silabs-MikeY/Peltier-Cell-Driver/ADC_Board.step

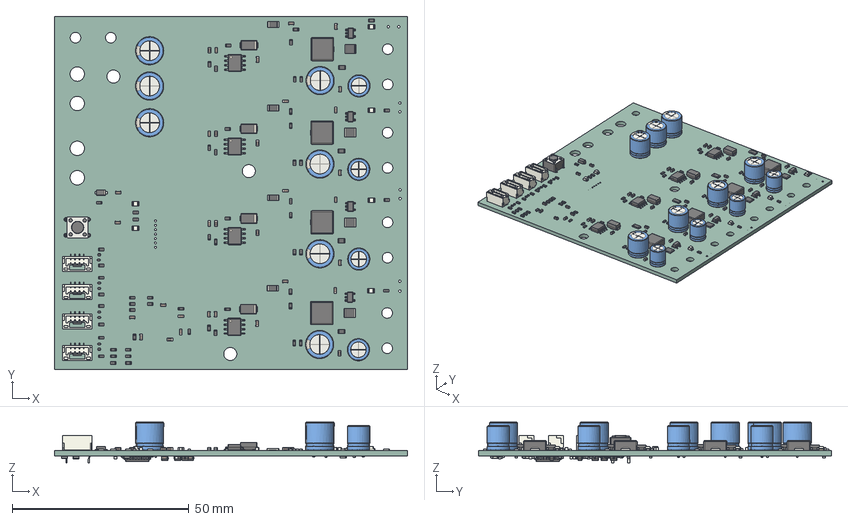
[picture p1: CAD file, 2026-09-24]
ADC_Board.step
100.0 x 100.0 x 11.5 mm
R_0603_1608Metric x 74
C_0603_1608Metric x 44
LED_0805_2012Metric x 6
SOIC-8_3.9x4.9mm_P1.27mm x 4
R_1210_3225Metric x 4
SOT-23-5 x 4
Fuse_1206_3216Metric x 8
C_Radial_D63mm_H70mm_P250mm x 4
D_SOD_923 x 14
D_SMA x 4
CP_Radial_D80mm_P350mm x 7
L_Changjiang_FXL0630 x 4
R_0805_2012Metric x 4
JST_BM04B_GHS_TBT x 4
SW_PUSH_6mm
D_SOD_123F
SOT-323_SC-70 x 7
LQFP-32_7x7mm_P0.8mm
ADCD332_PCB
