silabs-MikeY/Peltier-Cell-Driver/ADC_Board.pdf

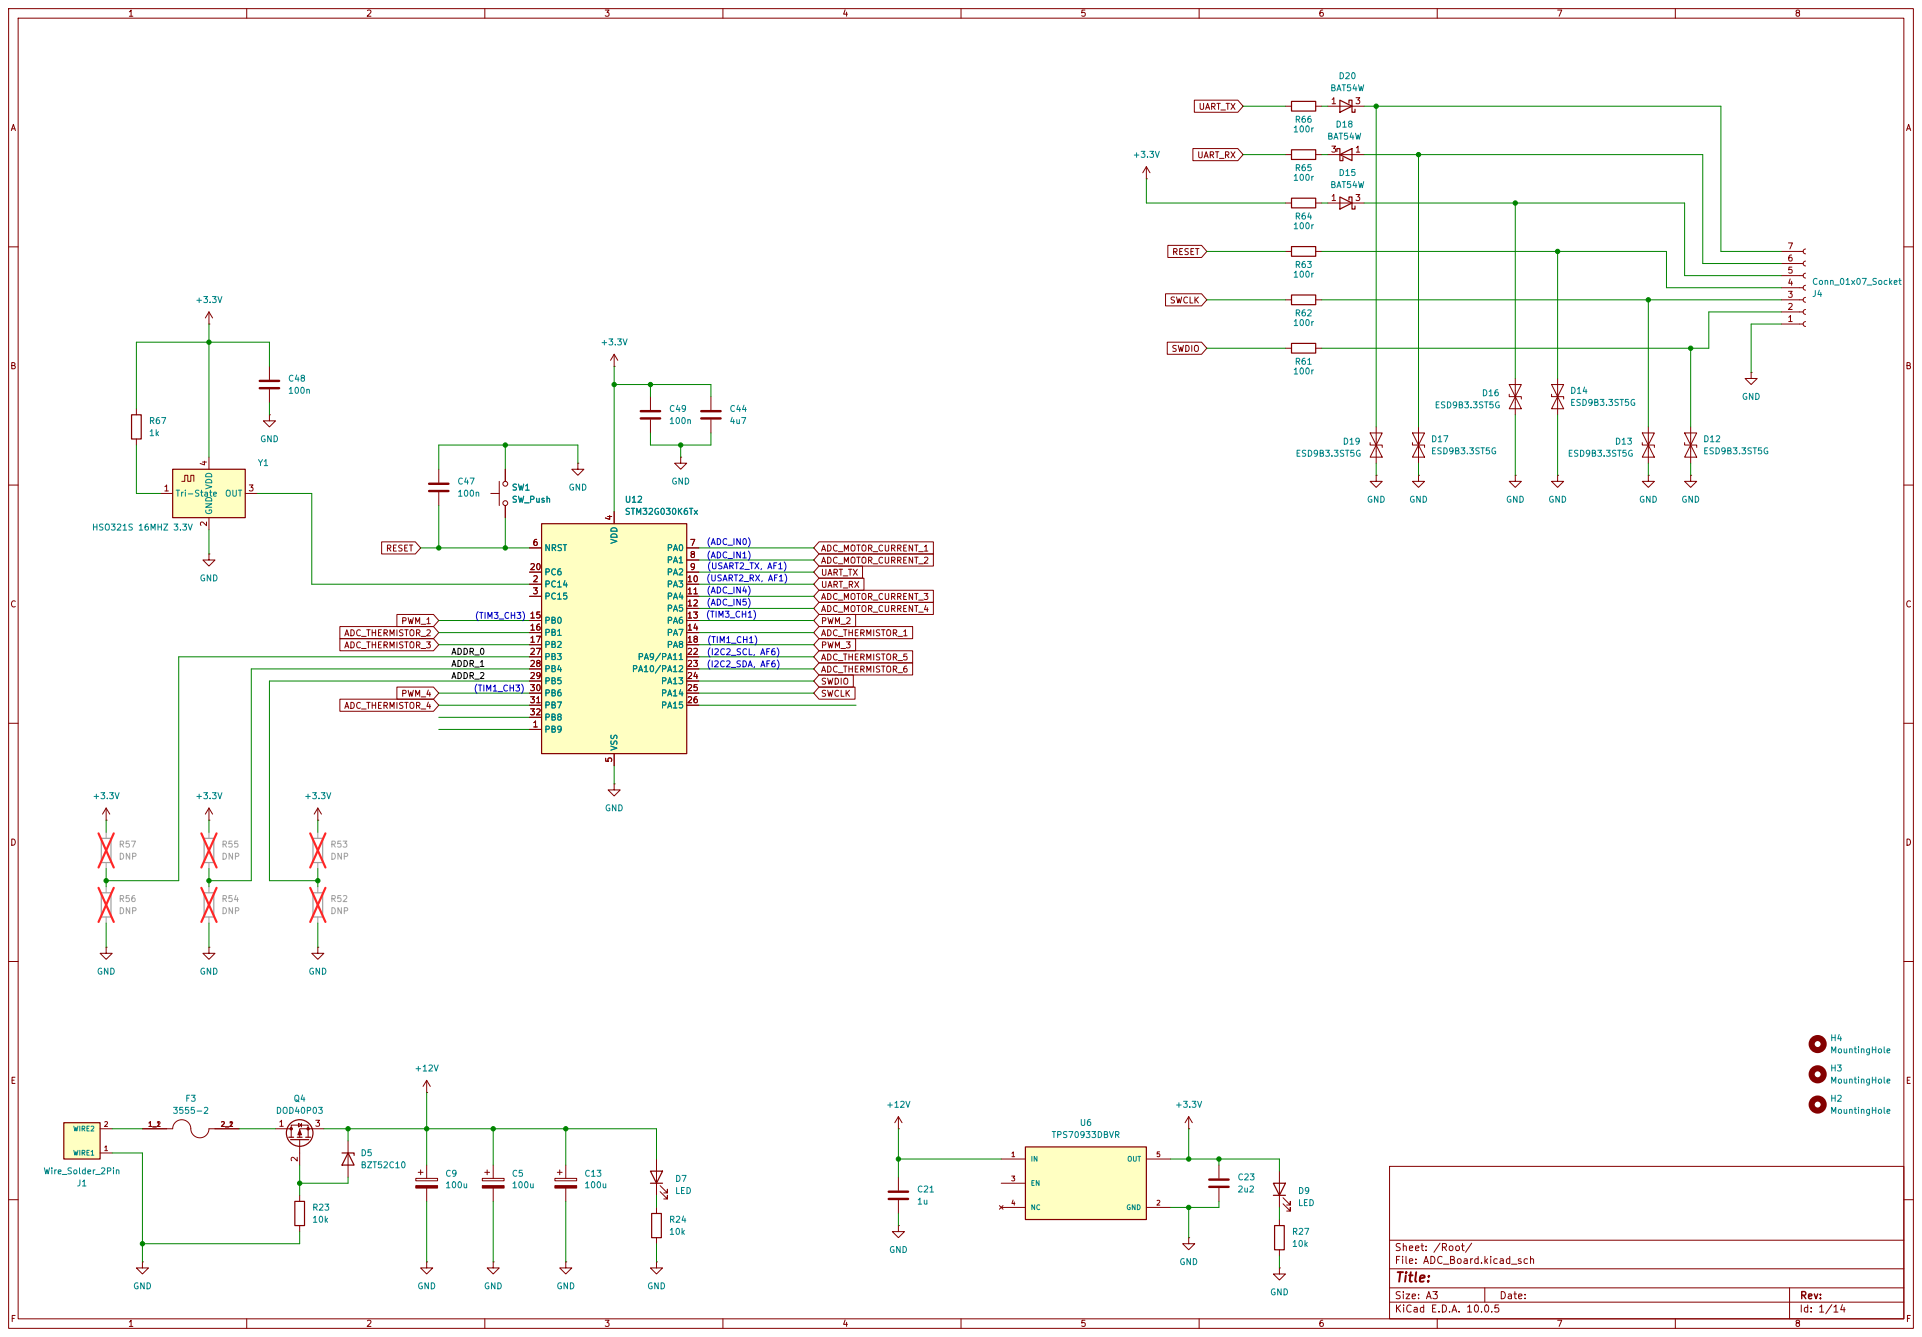
[picture p2: page 1]

Size: A3 | Rev: | F Date:
KiCad E.D.A. 10.0.5 | Id: 1/14

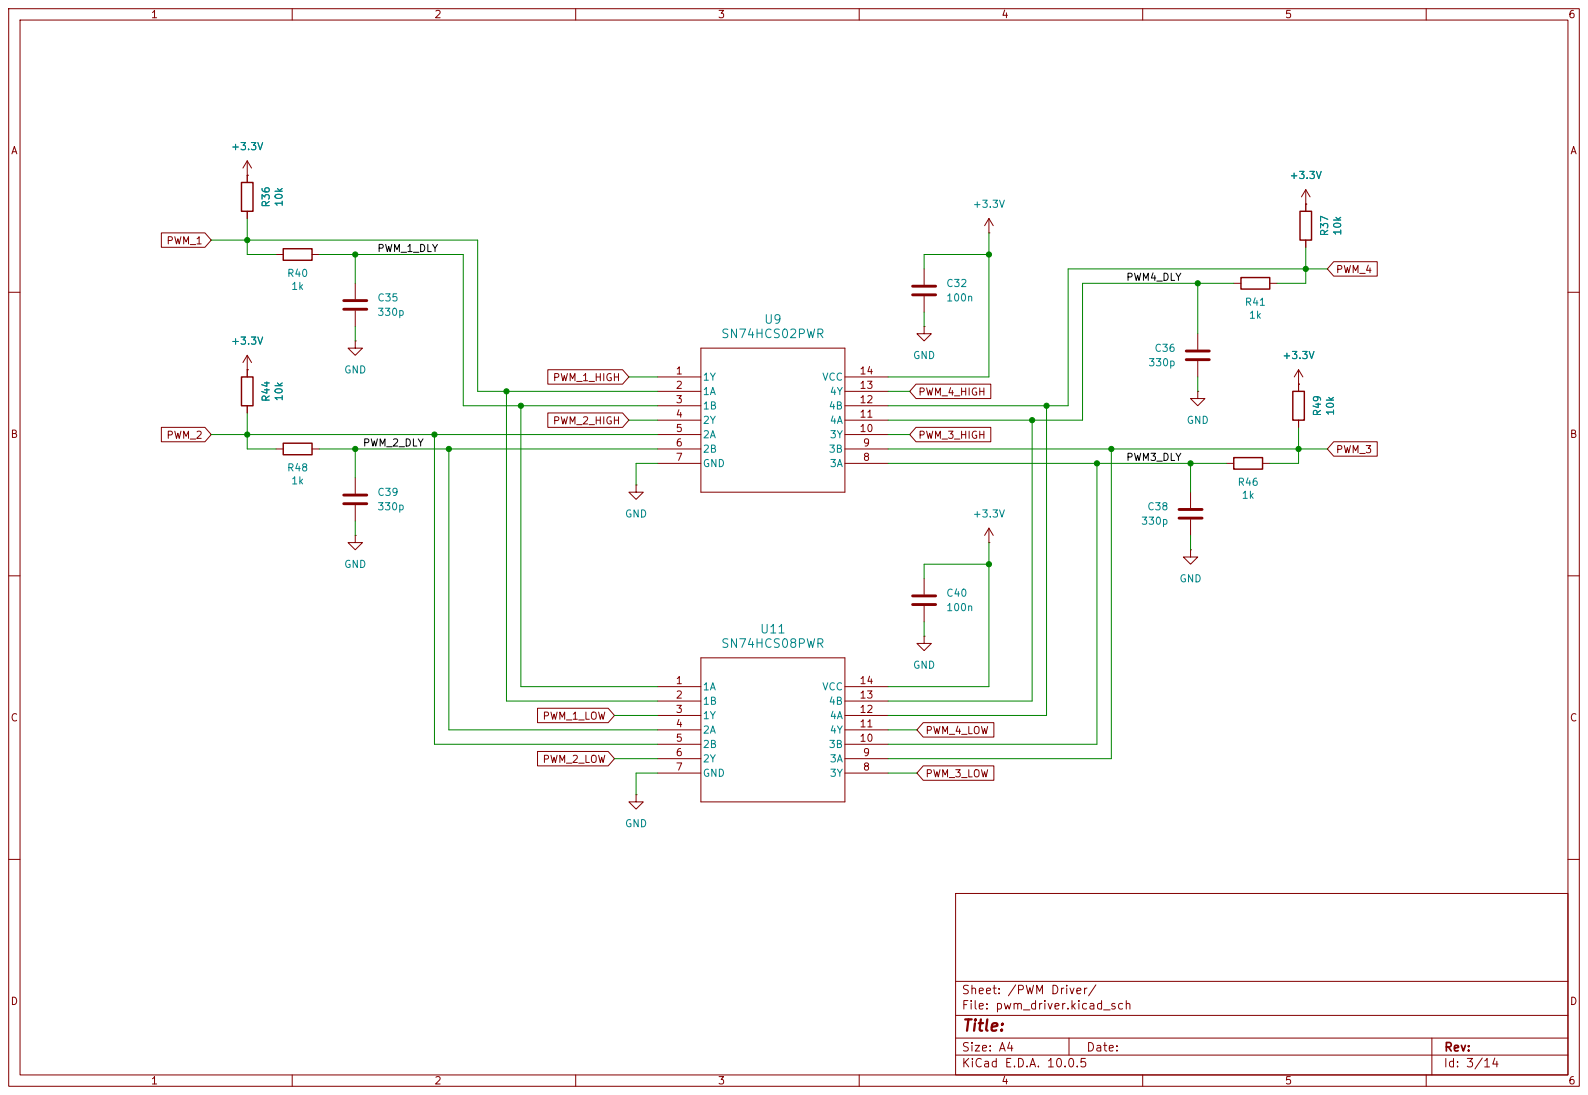
[picture p3: page 2]

1B 3
2Y 4 2A 5 2B 6 GND 7

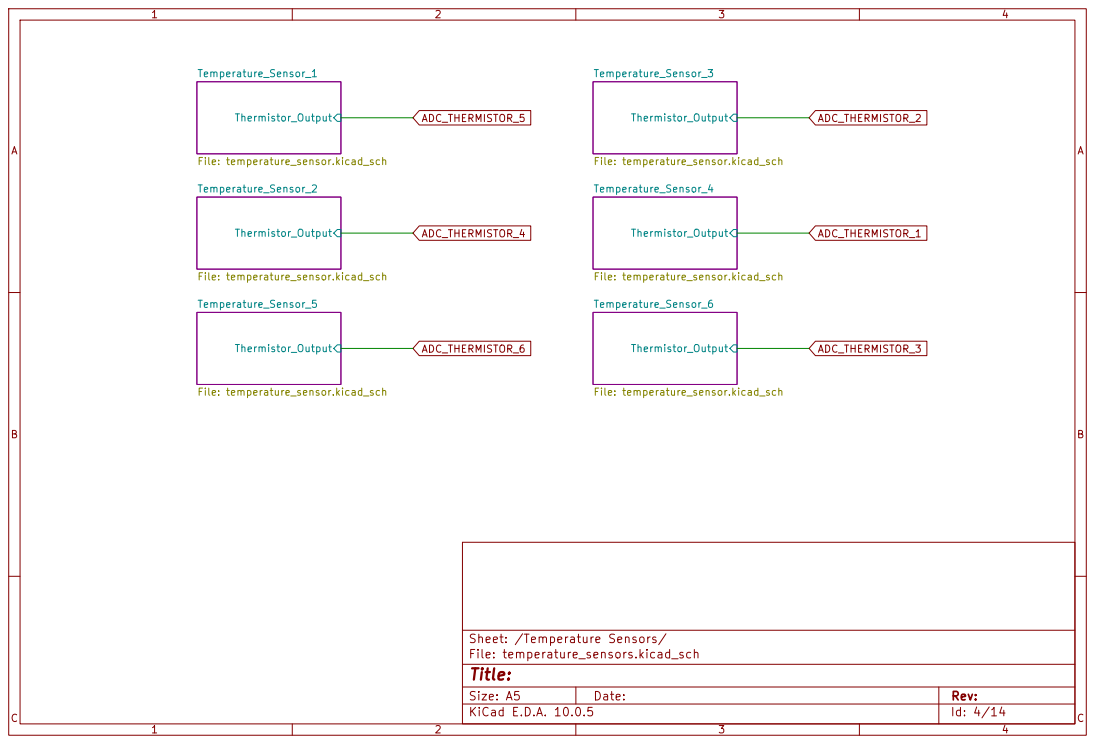
[picture p4: page 3]

Size: A5 | Rev: | C Date:
KiCad E.D.A. 10.0.5 | Id: 4/14

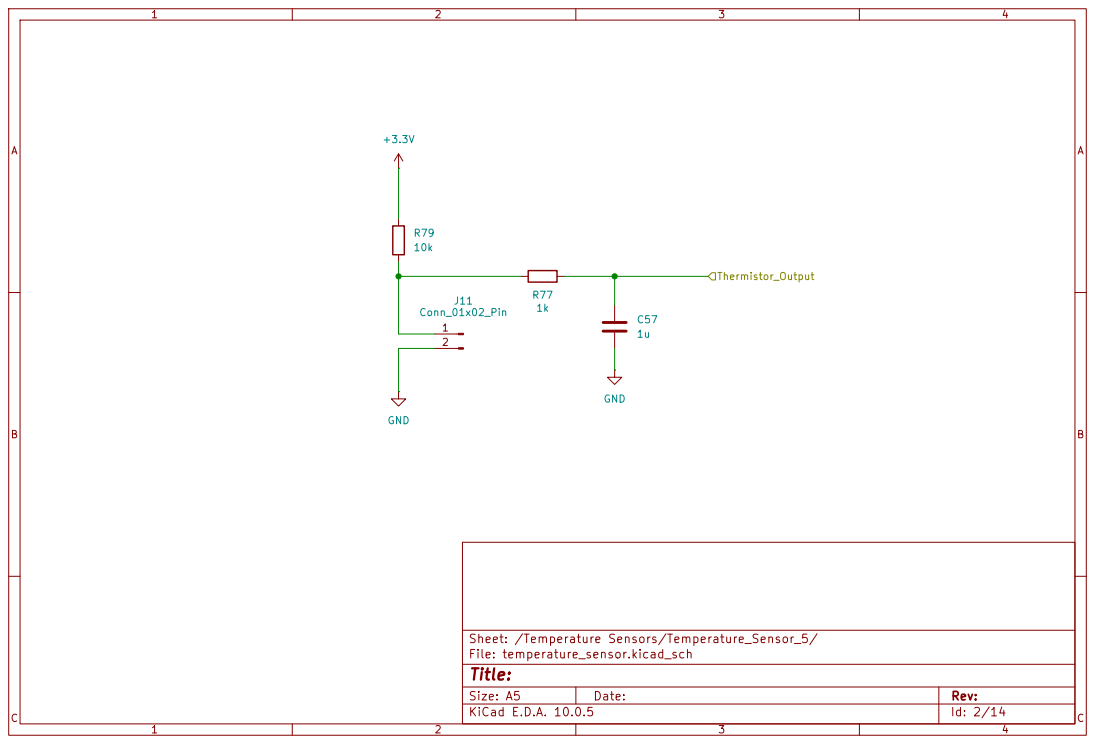
[picture p5: page 4]

Size: A5 | Rev: | C Date:
KiCad E.D.A. 10.0.5 | Id: 2/14

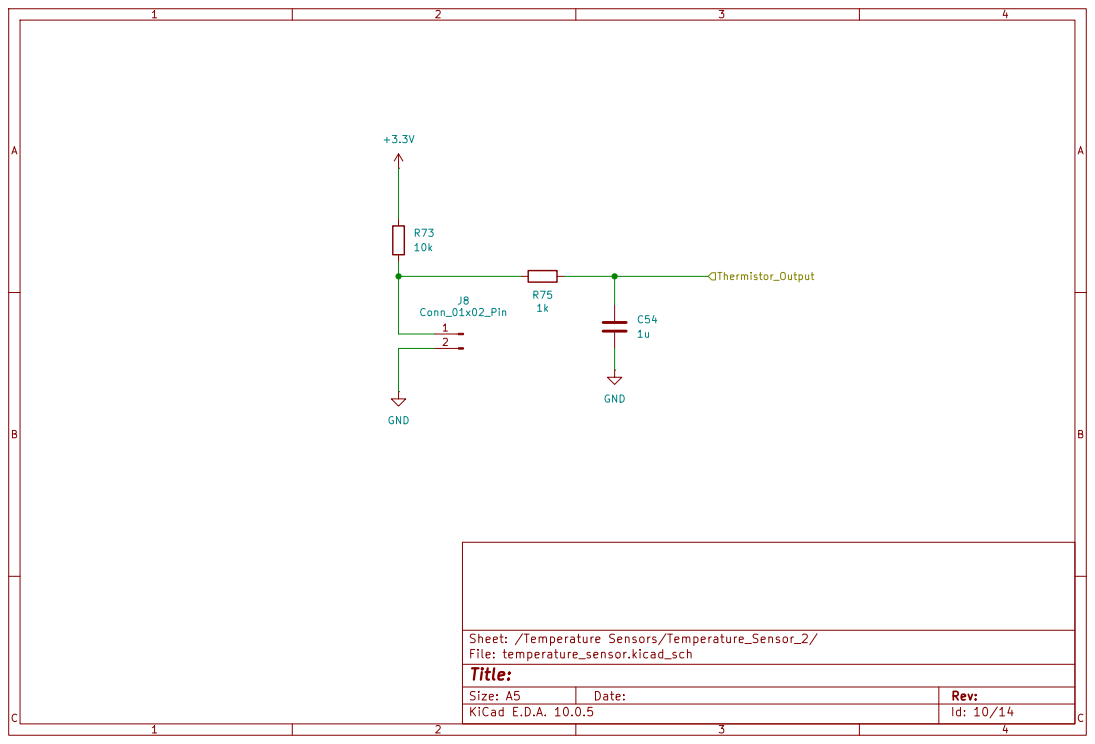
[picture p6: page 5]

Size: A5 | Rev: | C Date:
KiCad E.D.A. 10.0.5 | Id: 10/14

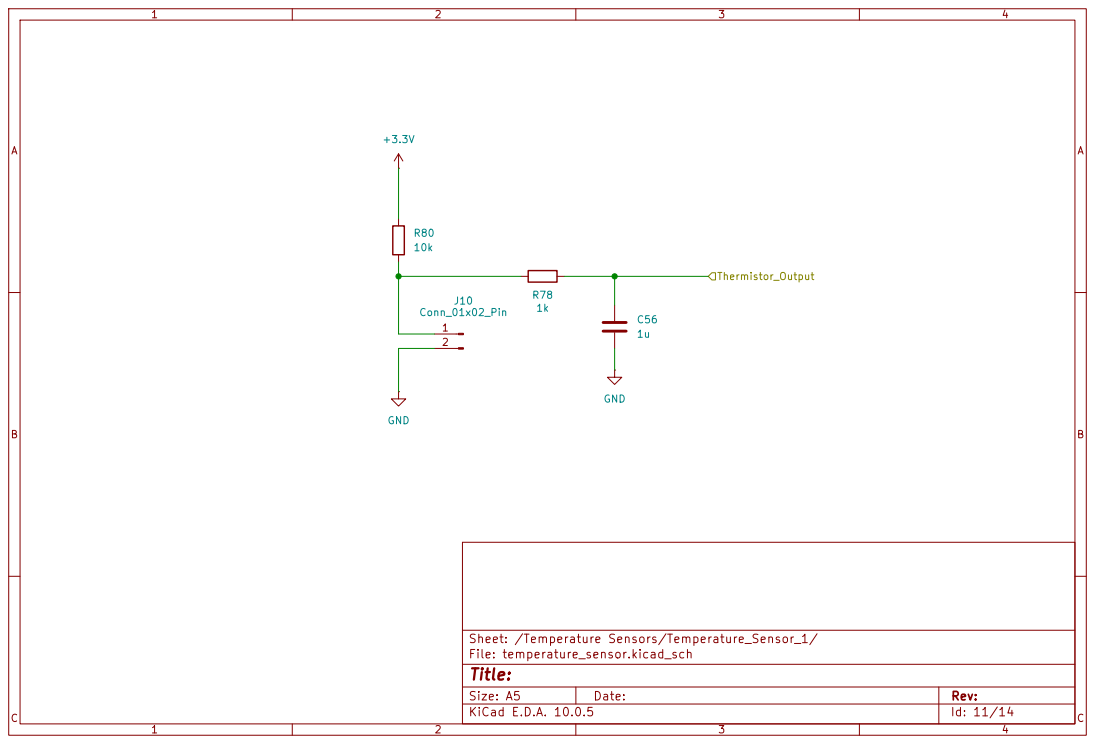
[picture p7: page 6]

Size: A5 | Rev: | C Date:
KiCad E.D.A. 10.0.5 | Id: 11/14

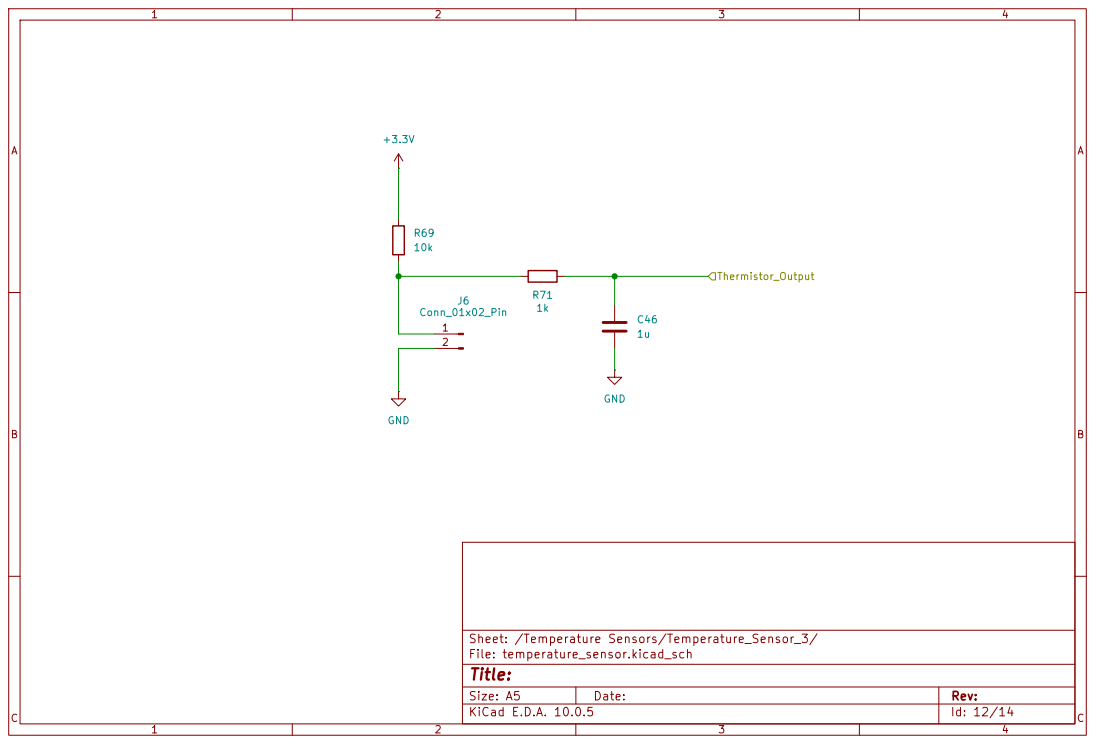
[picture p8: page 7]

Size: A5 | Rev: | C Date:
KiCad E.D.A. 10.0.5 | Id: 12/14

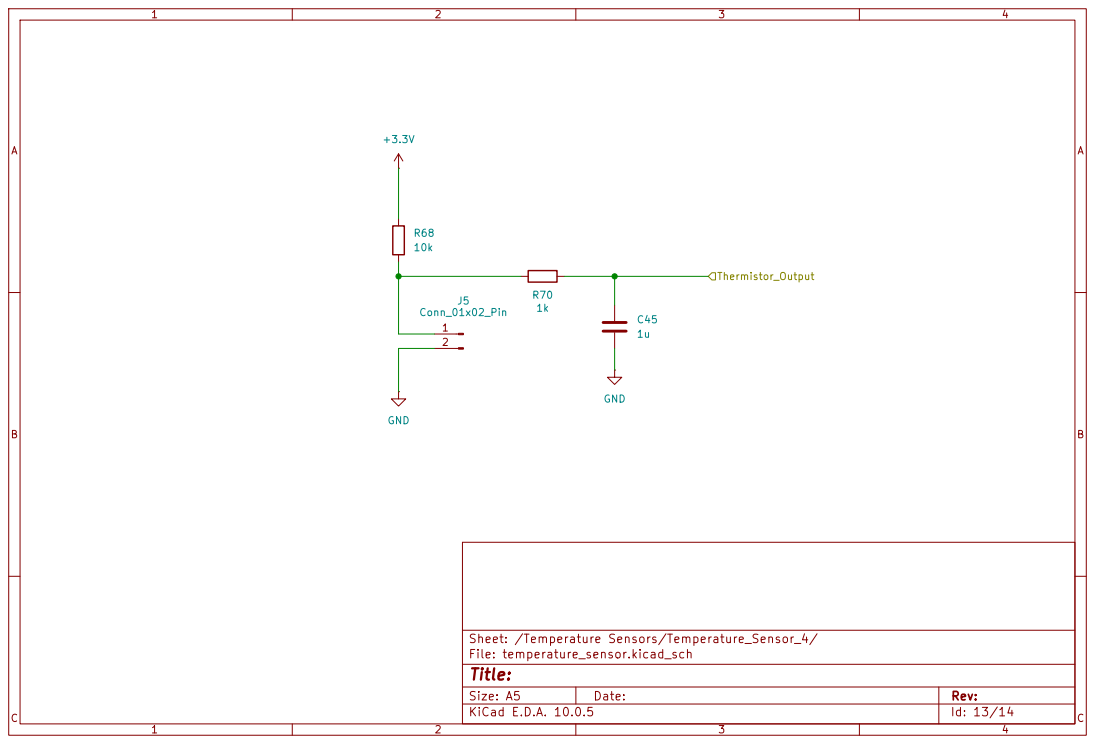
[picture p9: page 8]

Size: A5 | Rev: | C Date:
KiCad E.D.A. 10.0.5 | Id: 13/14

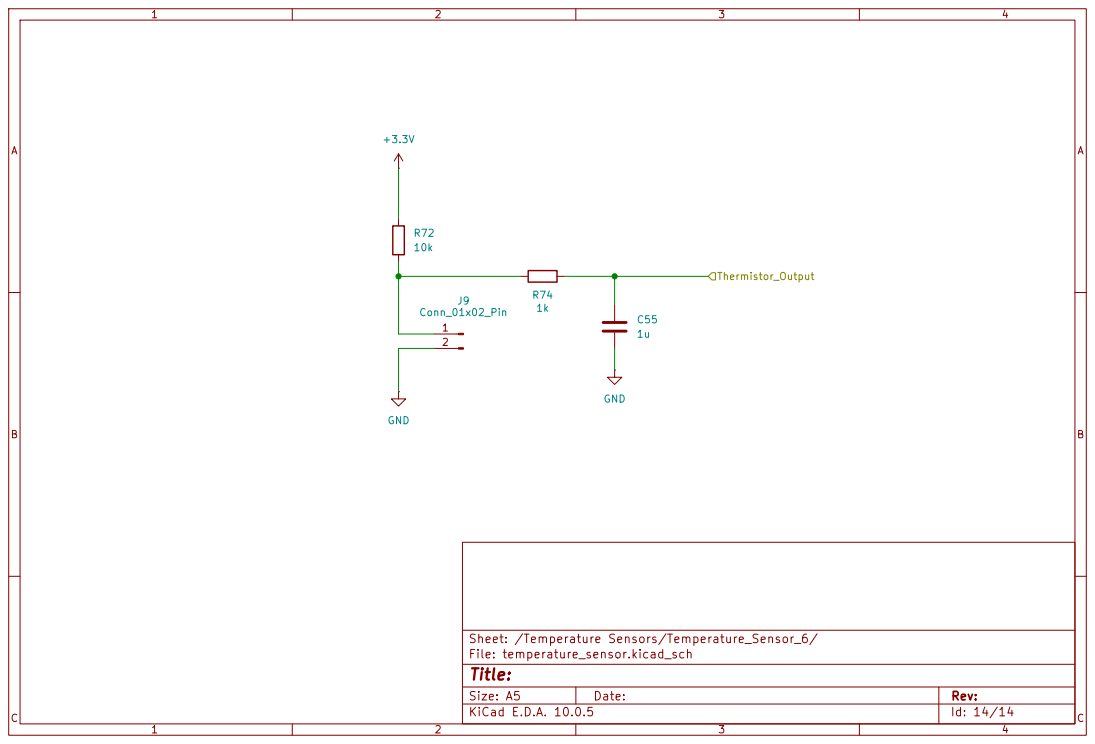
[picture p10: page 9]

Size: A5 | Rev: | C Date:
KiCad E.D.A. 10.0.5 | Id: 14/14

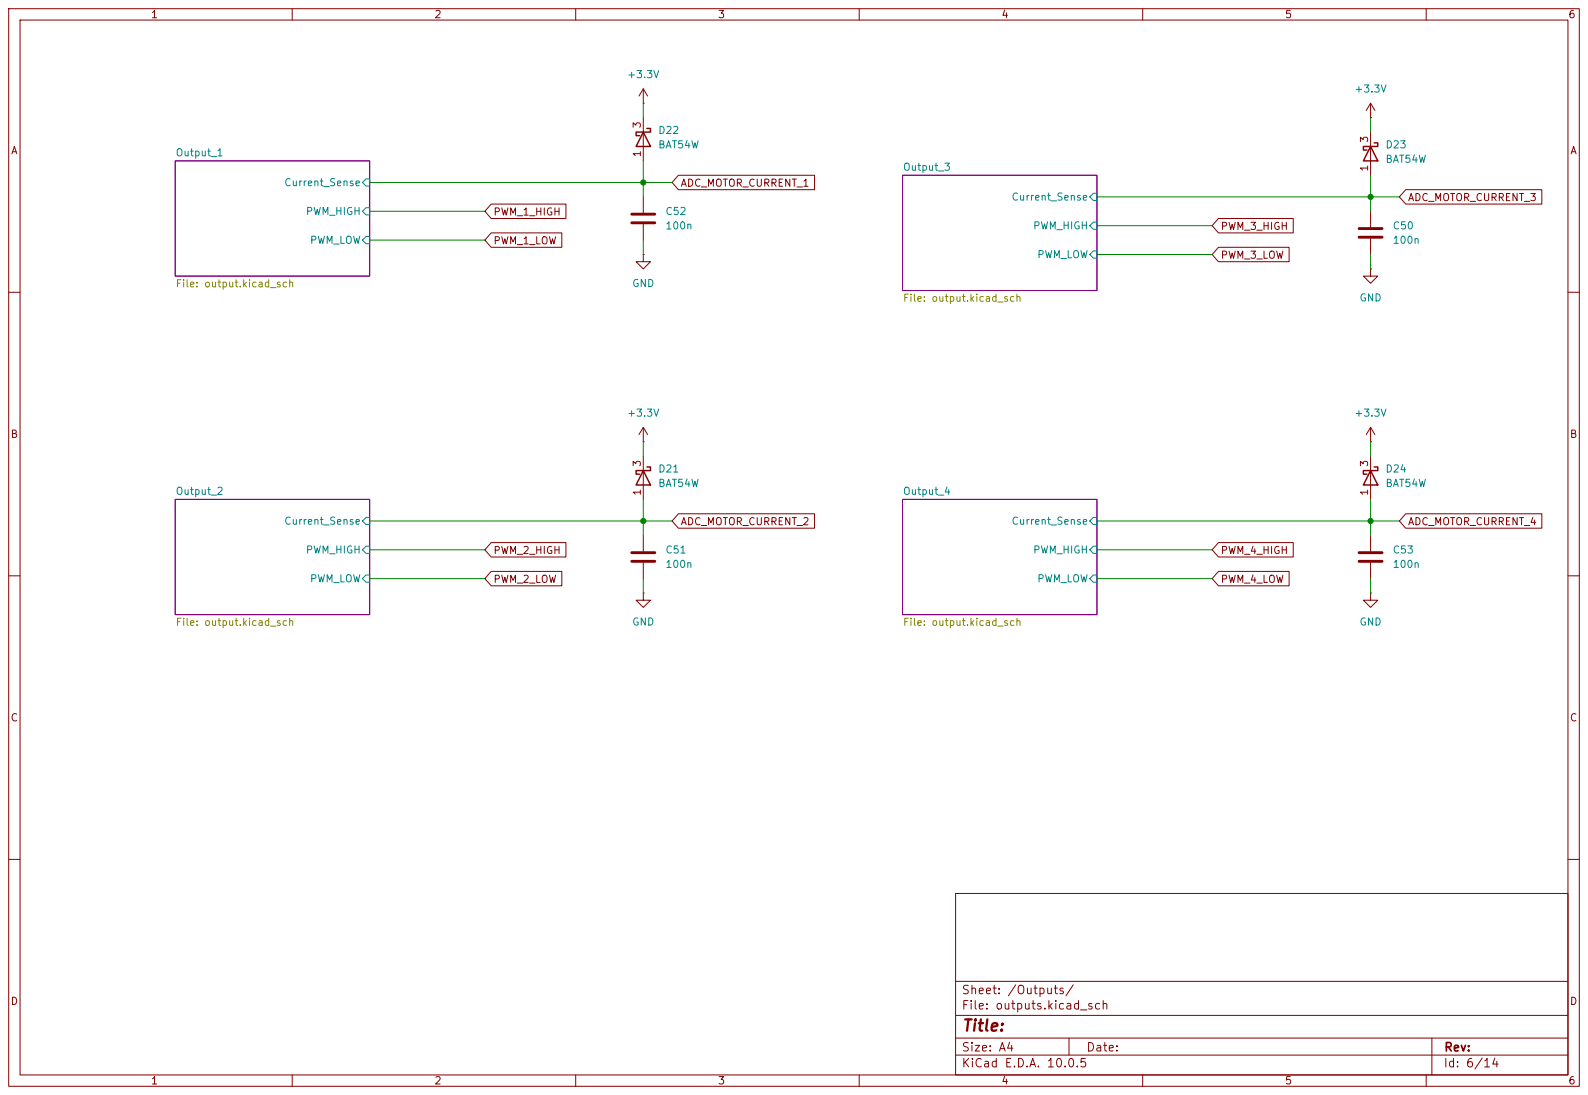
[picture p11: page 10]

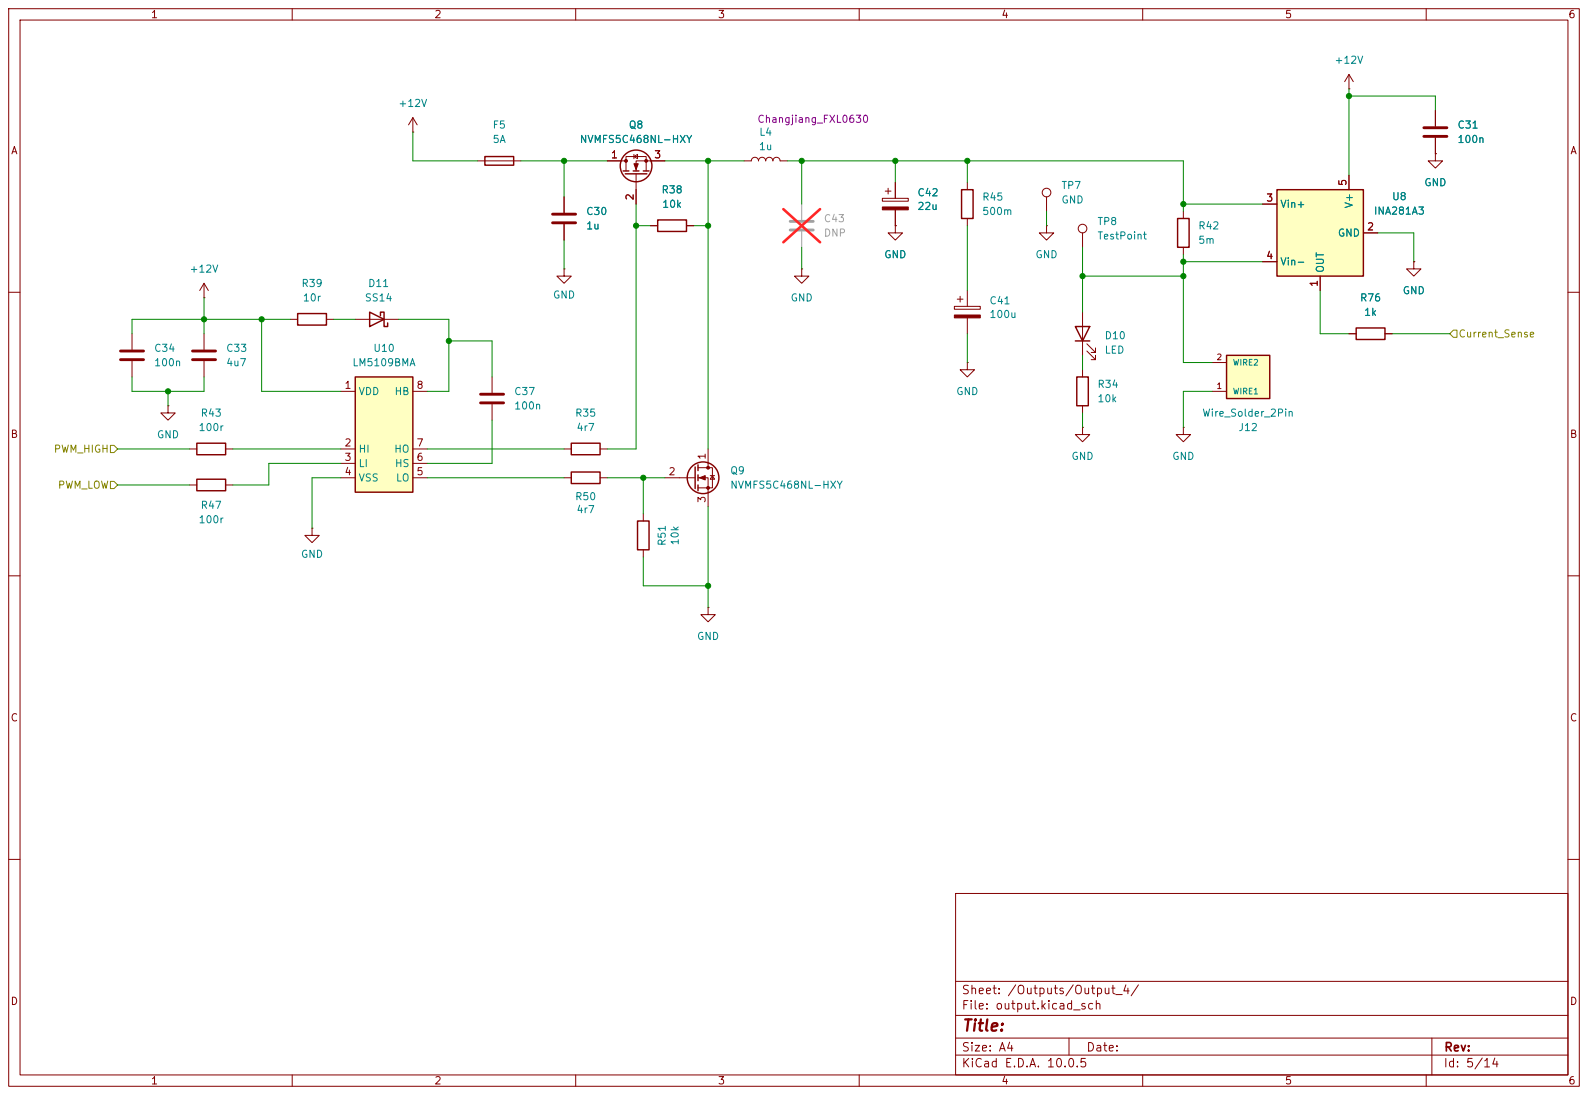
[picture p12: page 11]

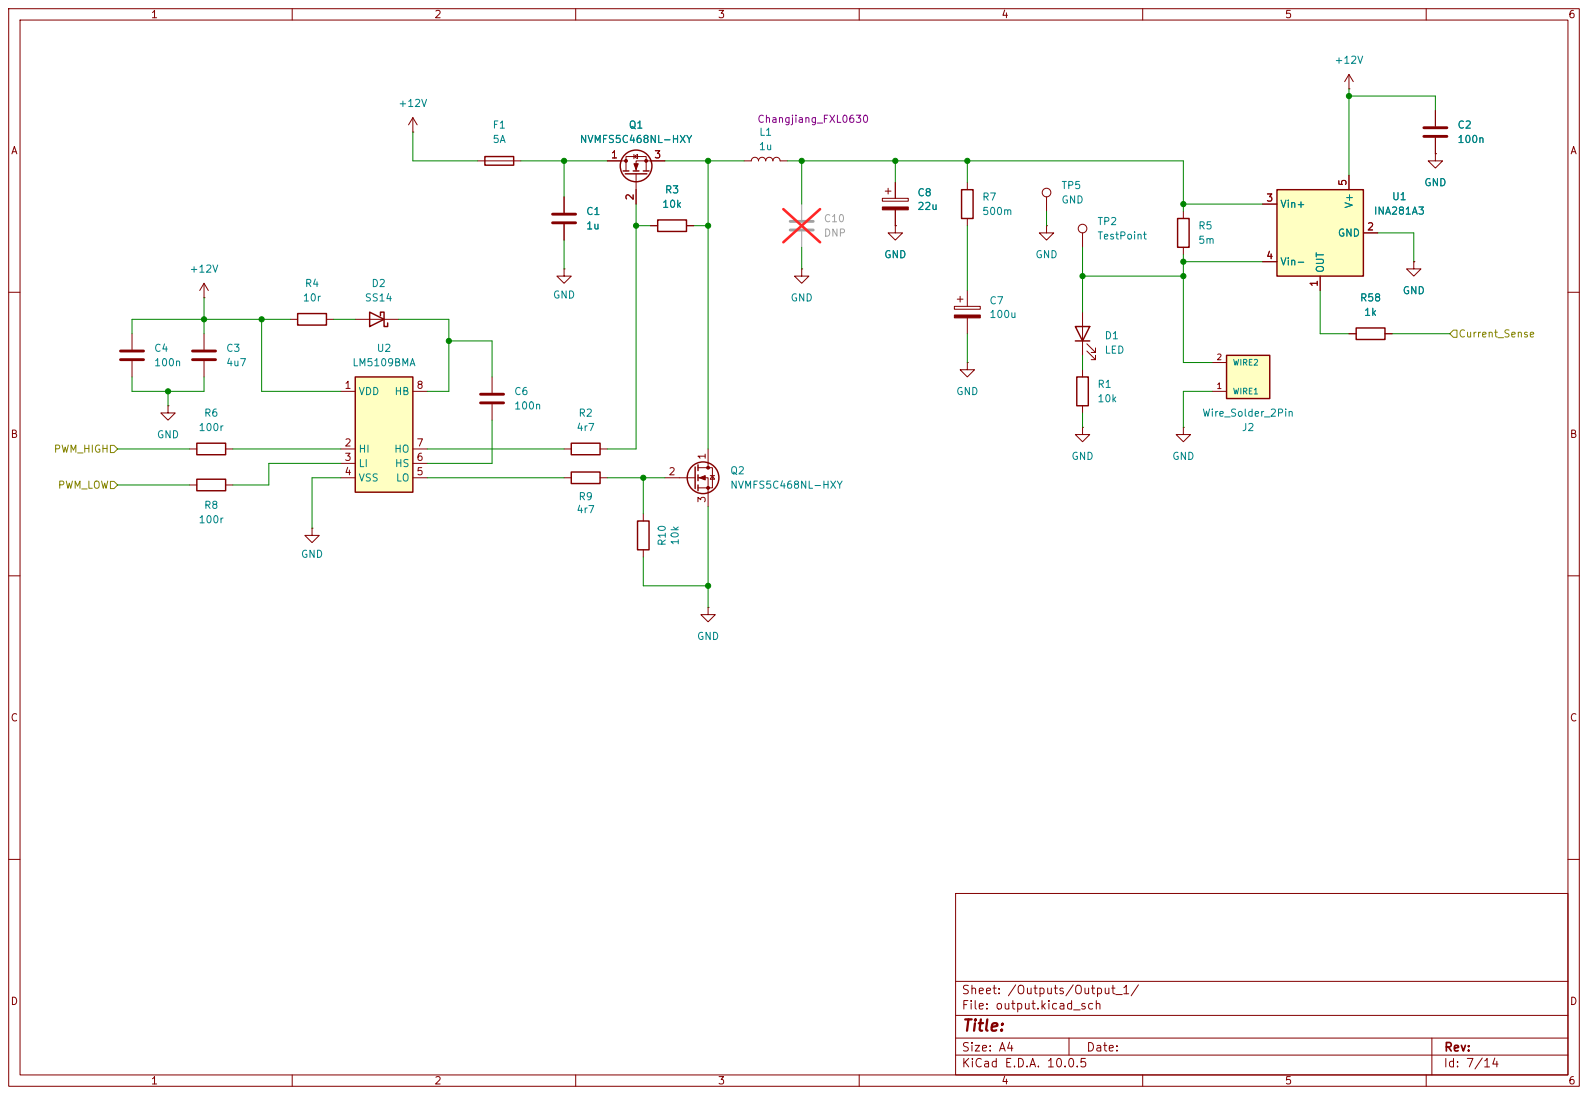
[picture p13: page 12]

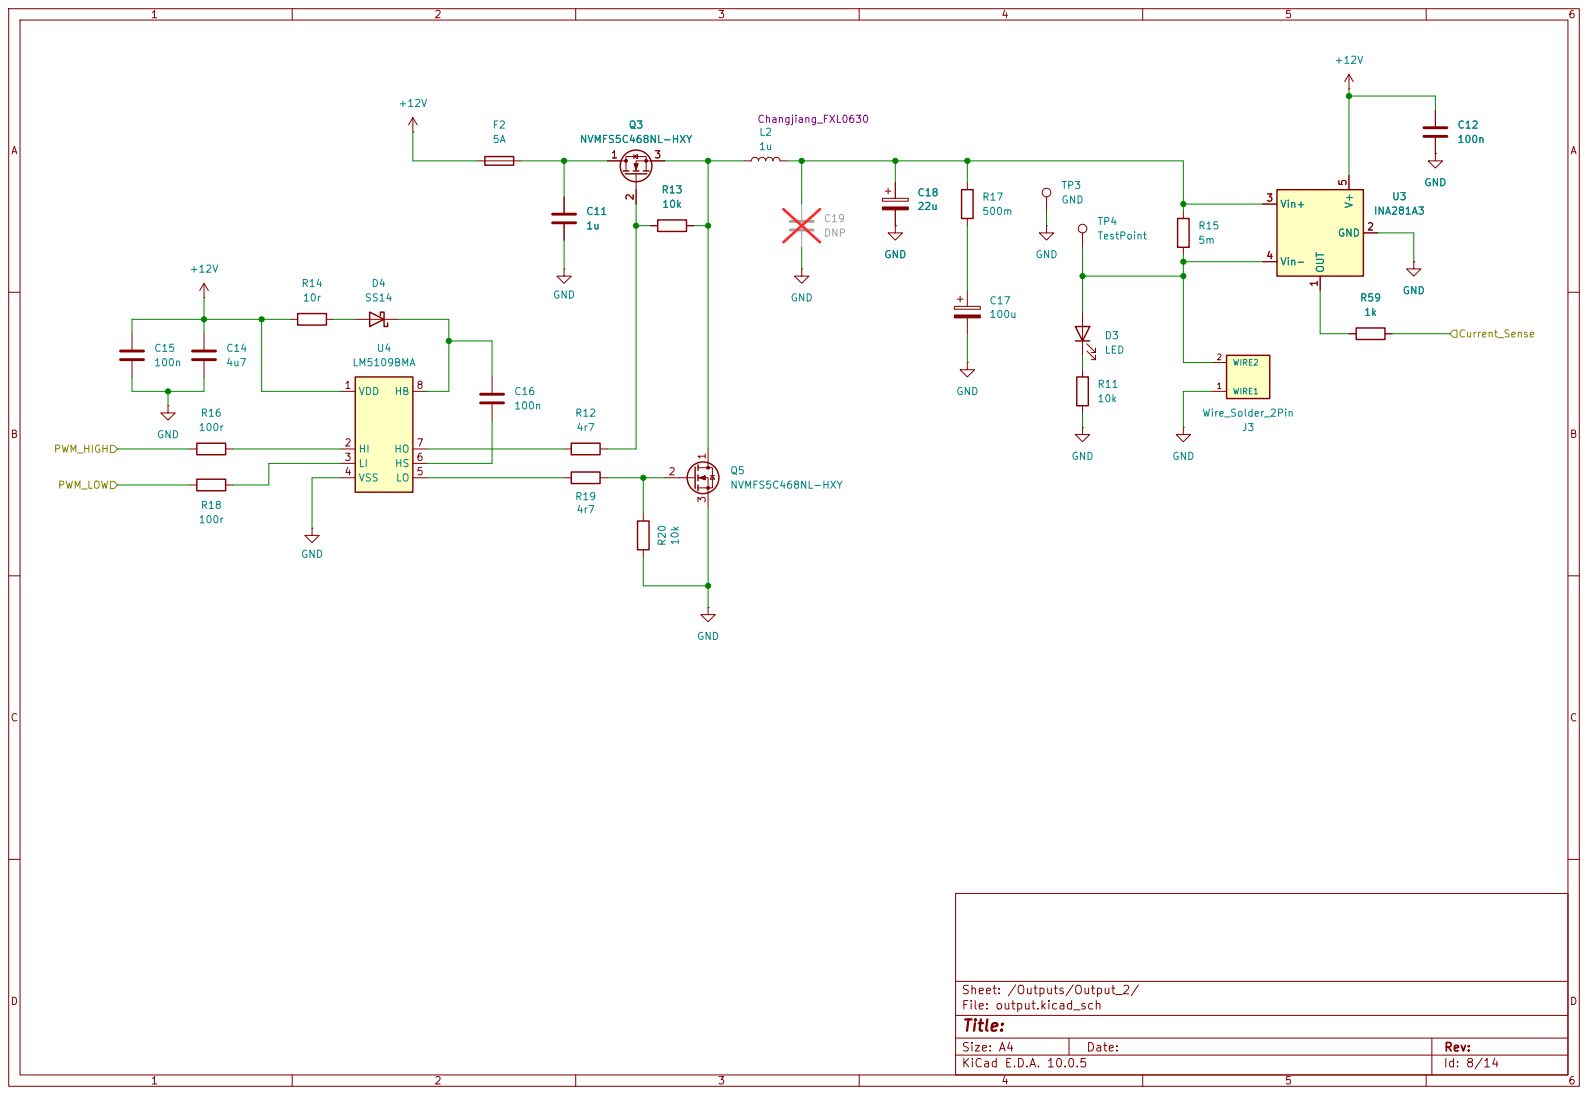
[picture p14: page 13]

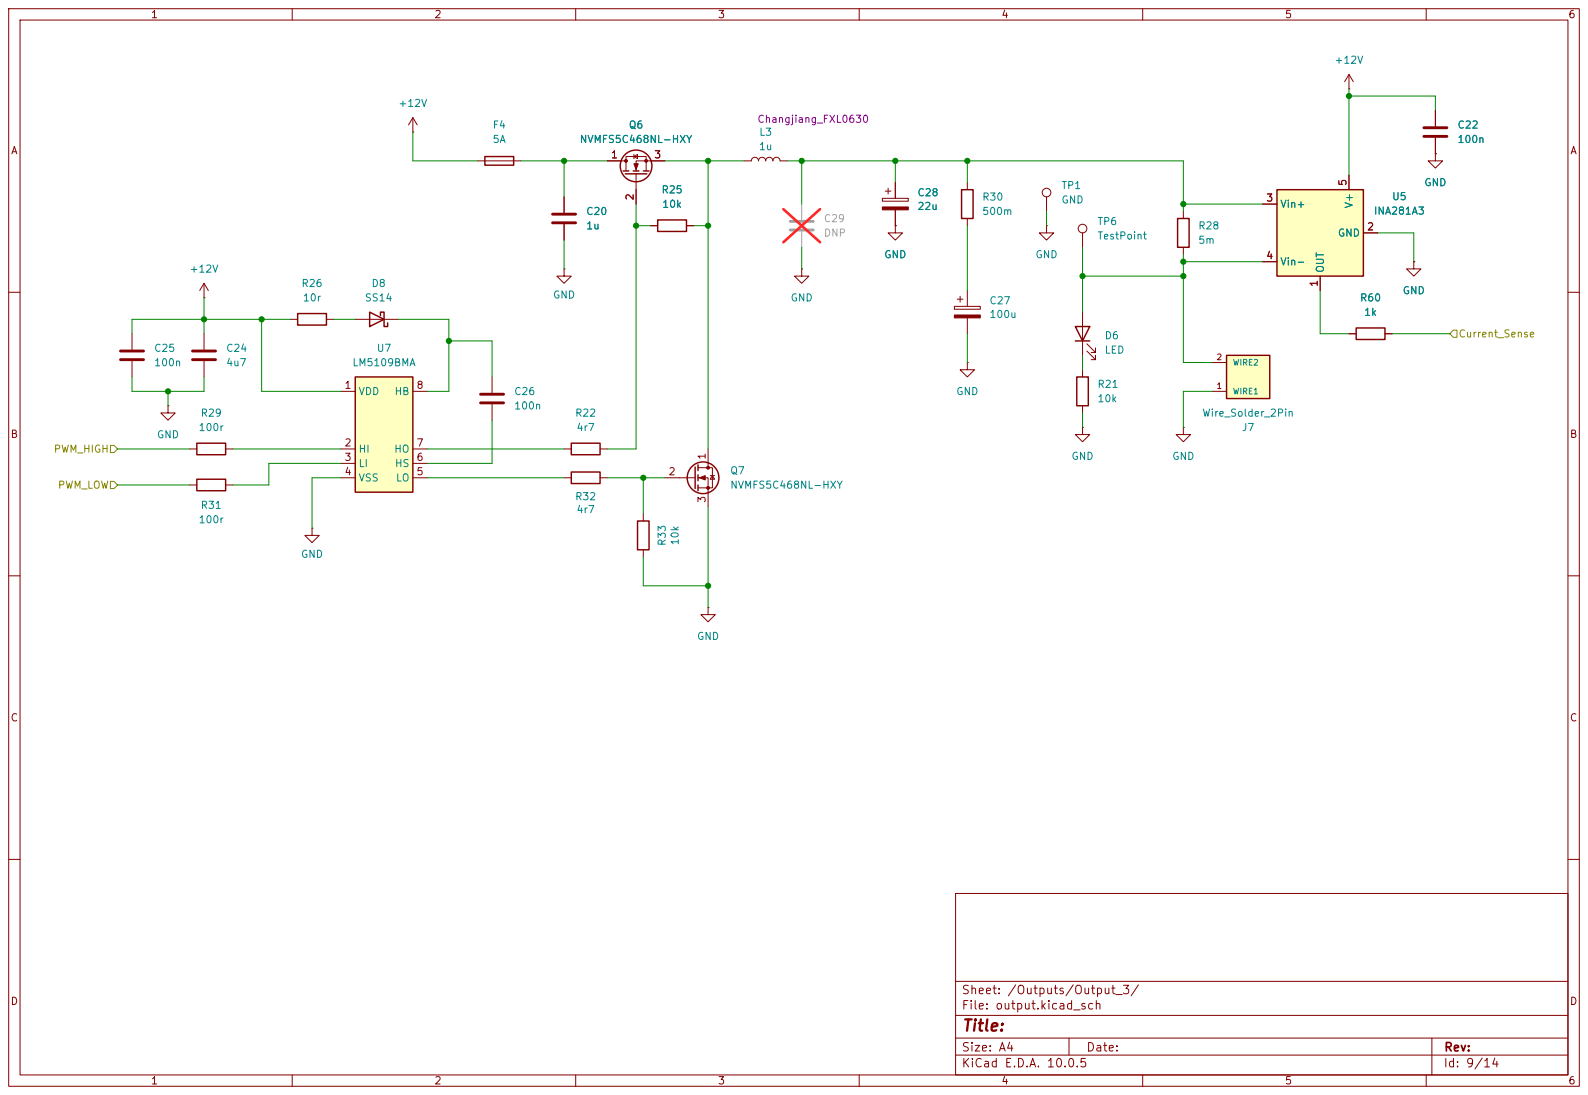
[picture p15: page 14]
