silabs-MikeY/Peltier-Cell-Driver/ADC_Board.kicad_pcb

## KiCad design ADC_Board.kicad_pcb (2026-09-23)

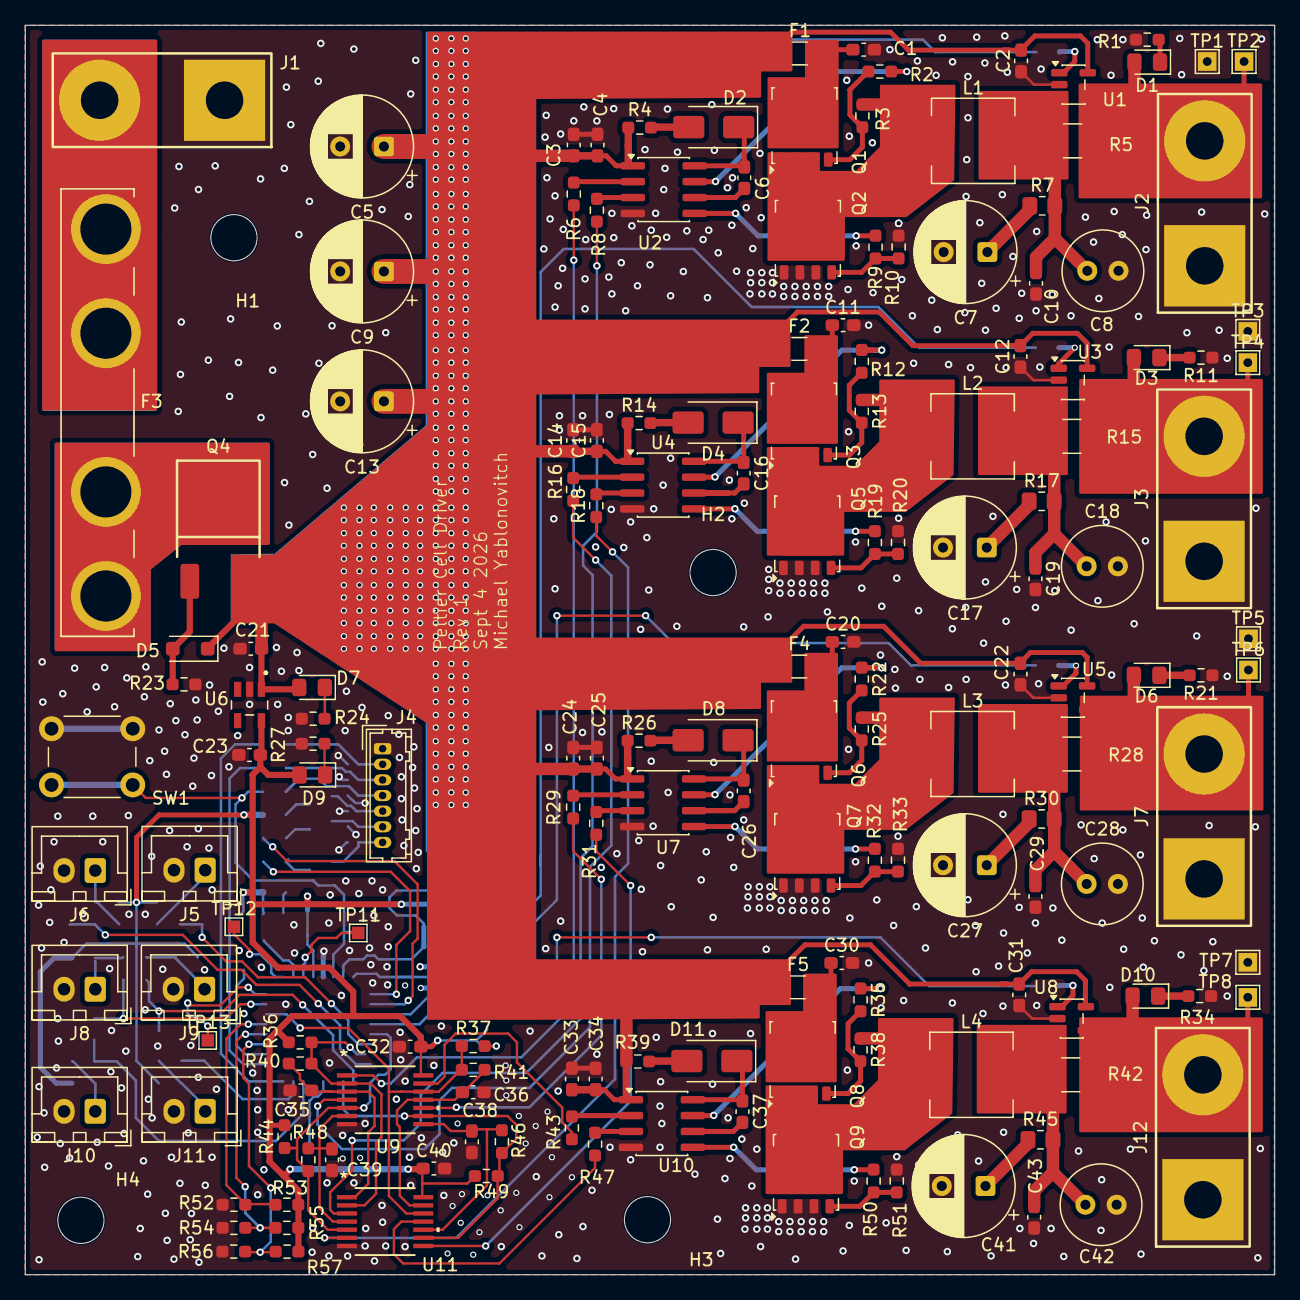
[picture p16: board ADC_Board.kicad_pcb from above]

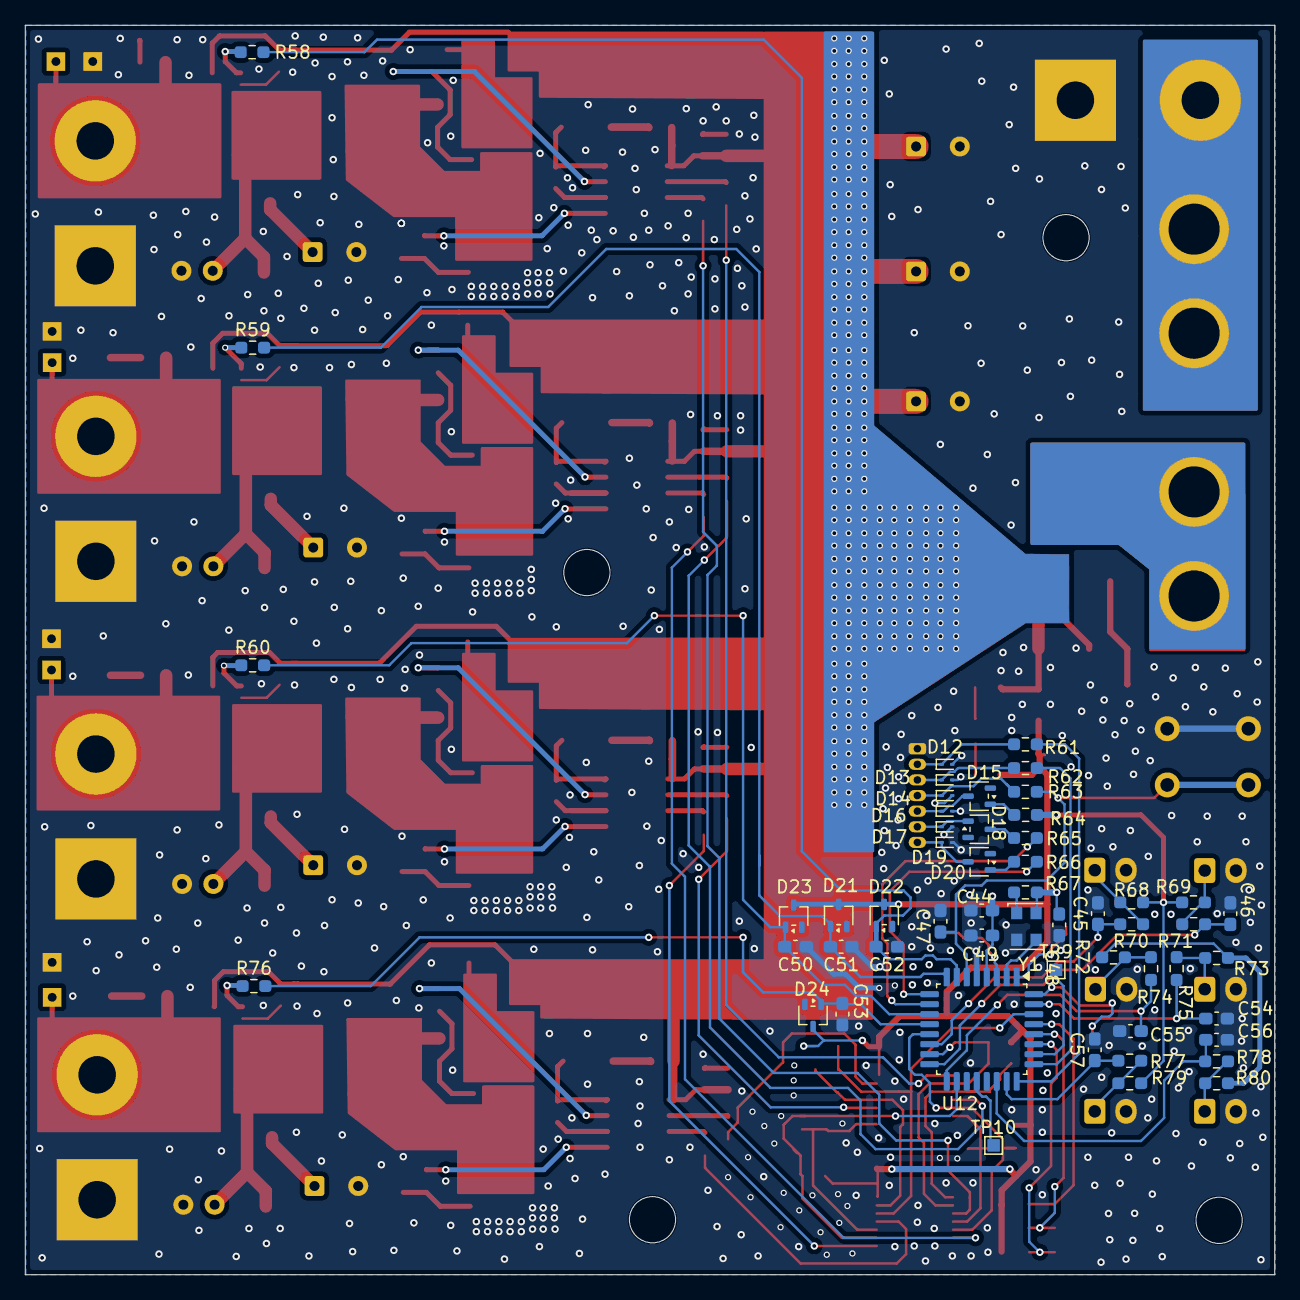
[picture p17: board ADC_Board.kicad_pcb from below]

Board: 4 copper layers, 100.0 x 100.0 mm, 222 parts (54 on the bottom side), 128 nets.

Parts:
C1, C11, C20, C21, C30, C45, C46, C54, C55, C56, C57: 1u; C_0603_1608Metric_Pad1.08x0.95mm_HandSolder
C2, C4, C6, C12, C15, C16, C22, C25, C26, C31, C32, C34, C37, C40, C47, C48, C49, C50, C51, C52, C53: 100n; C_0603_1608Metric_Pad1.08x0.95mm_HandSolder
C3, C14, C24, C33, C44: 4u7; C_0603_1608Metric_Pad1.08x0.95mm_HandSolder
C5, C7, C9, C13, C17, C27, C41: 100u; CP_Radial_D8.0mm_P3.50mm
C8, C18, C28, C42: 22u; C_Radial_D6.3mm_H7.0mm_P2.50mm
C10, C19, C29, C43: DNP; C_0603_1608Metric_Pad1.08x0.95mm_HandSolder
C23: 2u2; C_0603_1608Metric_Pad1.08x0.95mm_HandSolder
C35, C36, C38, C39: 330p; C_0603_1608Metric_Pad1.08x0.95mm_HandSolder
D1, D3, D6, D7, D9, D10: LED; LED_0805_2012Metric_Pad1.15x1.40mm_HandSolder
D2, D4, D8, D11: SS14; D_SMA
D5: BZT52C10; D_SOD-123F
D12, D13, D14, D16, D17, D19: ESD9B3.3ST5G; D_SOD-923
D15, D18, D20, D21, D22, D23, D24: BAT54W; SOT-323_SC-70
F1, F2, F4, F5: 5A; Fuse_1206_3216Metric
F3: 3555-2; FUSE_3555-2
H1, H2, H3, H4: MountingHole; MountingHole_3.7mm
J1, J2, J3, J7, J12: Wire_Solder_2Pin; Wire_Solder_2Pin_12-14AWG_P10mm_D3.0mm
J4: Conn_01x07_Socket; Hirose_DF13-07P-1.25DSA_1x07_P1.25mm_Vertical
J5, J6, J8, J9, J10, J11: Conn_01x02_Pin; JST_XH_B2B-XH-A_1x02_P2.50mm_Vertical
L1, L2, L3, L4: 1u; L_Changjiang_FXL0630
Q1, Q2, Q3, Q5, Q6, Q7, Q8, Q9: NVMFS5C468NL-HXY
Q4: DOD40P03; DOD40P03_TO-252_Q_PMOS_DGS
R1, R3, R10, R11, R13, R20, R21, R23, R24, R25, R27, R33, R34, R36, R37, R38, R44, R49, R51, R68, R69, R72, R73, R79, R80: 10k; R_0603_1608Metric_Pad0.98x0.95mm_HandSolder
R2, R9, R12, R19, R22, R32, R35, R50: 4r7; R_0603_1608Metric_Pad0.98x0.95mm_HandSolder
R4, R14, R26, R39: 10r; R_0603_1608Metric_Pad0.98x0.95mm_HandSolder
R5, R15, R28, R42: 5m; R_1210_3225Metric_Pad1.30x2.65mm_HandSolder
R6, R8, R16, R18, R29, R31, R43, R47, R61, R62, R63, R64, R65, R66: 100r; R_0603_1608Metric_Pad0.98x0.95mm_HandSolder
R7, R17, R30, R45: 500m; R_0805_2012Metric_Pad1.20x1.40mm_HandSolder
R40, R41, R46, R48, R58, R59, R60, R67, R70, R71, R74, R75, R76, R77, R78: 1k; R_0603_1608Metric_Pad0.98x0.95mm_HandSolder
R52, R53, R54, R55, R56, R57: DNP; R_0603_1608Metric_Pad0.98x0.95mm_HandSolder
SW1: SW_Push; SW_PUSH_6mm
TP1, TP3, TP5, TP7: GND; TestPoint_THTPad_1.5x1.5mm_Drill0.7mm
TP2, TP4, TP6, TP8: TestPoint; TestPoint_THTPad_1.5x1.5mm_Drill0.7mm
TP9, TP10, TP11, TP12, TP13: TestPoint; TestPoint_Pad_1.0x1.0mm
U1, U3, U5, U8: INA281A3; SOT-23-5
U2, U4, U7, U10: LM5109BMA; SOIC-8_3.9x4.9mm_P1.27mm
U6: TPS70933DBVR; SOT95P280X145-5N
U9: SN74HCS02PWR; TSSOP14_PW_TEX-M
U11: SN74HCS08PWR; TSSOP14_PW_TEX-M
U12: STM32G030K6Tx; LQFP-32_7x7mm_P0.8mm
Y1: HSO321S 16MHZ 3.3V; Oscillator_SMD_EuroQuartz_XO32-4Pin_3.2x2.5mm

Connections:
+3.3V: C23.1, C32.1, C40.1, C44.1, C48.2, C49.1, D9.2 (A), D21.3 (K), D22.3 (K), D23.3 (K), D24.3 (K), R36.2, R37.2, R44.2, R49.2, R53.2, R55.2, R57.2, R64.1, R67.2, R68.2, R69.2, R72.2, R73.2, R79.2, R80.2, U6.5 (OUT), U9.14 (VCC), U11.14 (VCC), U12.4 (VDD), Y1.4 (VDD)
+12V: C2.2, C3.1, C4.1, C5.1, C9.1, C12.2, C13.1, C14.1, C15.1, C21.1, C22.2, C24.1, C25.1, C31.2, C33.1, C34.1, D5.1 (K), D7.2 (A), F1.1, F2.1, F4.1, F5.1, Q4.3 (S), R4.1, R14.1, R26.1, R39.1, U1.5 (V+), U2.1 (VDD), U3.5 (V+), U4.1 (VDD), U5.5 (V+), U6.1 (IN), U7.1 (VDD), U8.5 (V+), U10.1 (VDD)
/PWM Driver/PWM3_DLY: C38.1, R46.2, U9.8 (3A), U11.10 (3B)
/PWM Driver/PWM4_DLY: C36.1, R41.2, U9.11 (4A), U11.13 (4B)
/PWM Driver/PWM_1_DLY: C35.1, R40.2, U9.3 (1B), U11.1 (1A)
/PWM Driver/PWM_2_DLY: C39.1, R48.2, U9.6 (2B), U11.4 (2A)
/Root/ADDR_0: R56.2, R57.1, U12.27 (PB3)
/Root/ADDR_1: R54.2, R55.1, U12.28 (PB4)
/Root/ADDR_2: R52.2, R53.1, U12.29 (PB5)
ADC_MOTOR_CURRENT_1: C52.2, D22.1 (A), R58.2, U12.7 (PA0)
ADC_MOTOR_CURRENT_2: C51.2, D21.1 (A), R59.2, U12.8 (PA1)
ADC_MOTOR_CURRENT_3: C50.2, D23.1 (A), R60.2, U12.11 (PA4)
ADC_MOTOR_CURRENT_4: C53.2, D24.1 (A), R76.2, U12.12 (PA5)
ADC_THERMISTOR_1: C45.1, R70.2, U12.14 (PA7)
ADC_THERMISTOR_2: C46.1, R71.2, U12.16 (PB1)
ADC_THERMISTOR_3: C55.1, R74.2, U12.17 (PB2)
ADC_THERMISTOR_4: C54.1, R75.2, U12.31 (PB7)
ADC_THERMISTOR_5: C56.1, R78.2, U12.22 (PA9/PA11)
ADC_THERMISTOR_6: C57.1, R77.2, U12.23 (PA10/PA12)
GND: C1.2, C2.1, C3.2, C4.2, C5.2, C7.2, C8.2, C9.2, C10.2, C11.2, C12.1, C13.2, C14.2, C15.2, C17.2, C18.2, C19.2, C20.2, C21.2, C22.1, C23.2, C24.2, C25.2, C27.2, C28.2, C29.2, C30.2, C31.1, C32.2, C33.2, C34.2, C35.2, C36.2, C38.2, C39.2, C40.2, C41.2, C42.2, C43.2, C44.2, C45.2, C46.2, C47.2, C48.1, C49.2, C50.1, C51.1, C52.1, C53.1, C54.2, C55.2, C56.2, C57.2, D12.2 (A2), D13.2 (A2), D14.2 (A2), D16.2 (A2), D17.2 (A2), D19.2 (A2), J1.1 (WIRE1), J2.1 (WIRE1), J3.1 (WIRE1), J4.1, J5.2, J6.2, J7.1 (WIRE1), J8.2, J9.2, J10.2, J11.2, J12.1 (WIRE1), Q2.3 (S), Q5.3 (S), Q7.3 (S), Q9.3 (S), R1.1, R10.1, R11.1, R20.1, R21.1, R23.1, R24.1, R27.1, R33.1, R34.1, R51.1, R52.1, R54.1, R56.1, SW1.2, TP1.1 (1_1), TP3.1 (1_1), TP5.1 (1_1), TP7.1 (1_1), U1.2 (GND), U2.4 (VSS), U3.2 (GND), U4.4 (VSS), U5.2 (GND), U6.2 (GND), U7.4 (VSS), U8.2 (GND), U9.7 (GND), U10.4 (VSS), U11.7 (GND), U12.5 (VSS), Y1.2 (GND)
unnamed: C7.1, R7.1
unnamed: C17.1, R17.1
unnamed: C27.1, R30.1
unnamed: C41.1, R45.1
unnamed: D1.2 (A), J2.2 (WIRE2), R5.2, TP2.1 (1_1), U1.4 (Vin-)
unnamed: D1.1 (K), R1.2
unnamed: D2.2 (A), R4.2
unnamed: C6.1, D2.1 (K), U2.8 (HB)
unnamed: D3.2 (A), J3.2 (WIRE2), R15.2, TP4.1 (1_1), U3.4 (Vin-)
unnamed: D3.1 (K), R11.2
unnamed: D4.2 (A), R14.2
unnamed: C16.1, D4.1 (K), U4.8 (HB)
unnamed: D5.2 (A), Q4.2 (G), R23.2
unnamed: D6.2 (A), J7.2 (WIRE2), R28.2, TP6.1 (1_1), U5.4 (Vin-)
unnamed: D6.1 (K), R21.2
unnamed: D7.1 (K), R24.2
unnamed: D8.2 (A), R26.2
unnamed: C26.1, D8.1 (K), U7.8 (HB)
unnamed: D9.1 (K), R27.2
unnamed: D10.2 (A), J12.2 (WIRE2), R42.2, TP8.1 (1_1), U8.4 (Vin-)
unnamed: D10.1 (K), R34.2
unnamed: D11.2 (A), R39.2
unnamed: C37.1, D11.1 (K), U10.8 (HB)
unnamed: D12.1 (A1), J4.2, R61.2
unnamed: D13.1 (A1), J4.3, R62.2
unnamed: D14.1 (A1), J4.4, R63.2
unnamed: D15.1 (A), R64.2
unnamed: D15.3 (K), D16.1 (A1), J4.5
unnamed: D17.1 (A1), D18.1 (A), J4.6
unnamed: D18.3 (K), R65.2
unnamed: D19.1 (A1), D20.3 (K), J4.7
unnamed: D20.1 (A), R66.2
unnamed: F3.1_1, F3.1_2, J1.2 (WIRE2)
unnamed: J5.1, R68.1, R70.1
unnamed: J6.1, R69.1, R71.1
unnamed: J8.1, R73.1, R75.1
unnamed: J9.1, R72.1, R74.1
unnamed: J10.1, R78.1, R80.1
unnamed: J11.1, R77.1, R79.1
unnamed: C1.1, F1.2, Q1.1 (D)
unnamed: Q1.2 (G), R2.2, R3.2
unnamed: L1.1, Q1.3 (S), Q2.1 (D), R3.1
unnamed: Q2.2 (G), R9.2, R10.2
unnamed: C11.1, F2.2, Q3.1 (D)
unnamed: Q3.2 (G), R12.2, R13.2
unnamed: L2.1, Q3.3 (S), Q5.1 (D), R13.1
unnamed: F3.2_1, F3.2_2, Q4.1 (D)
unnamed: Q5.2 (G), R19.2, R20.2
unnamed: C20.1, F4.2, Q6.1 (D)
unnamed: Q6.2 (G), R22.2, R25.2
unnamed: L3.1, Q6.3 (S), Q7.1 (D), R25.1
unnamed: Q7.2 (G), R32.2, R33.2
unnamed: C30.1, F5.2, Q8.1 (D)
unnamed: Q8.2 (G), R35.2, R38.2
unnamed: L4.1, Q8.3 (S), Q9.1 (D), R38.1
unnamed: Q9.2 (G), R50.2, R51.2
unnamed: R58.1, U1.1 (OUT)
unnamed: C8.1, C10.1, L1.2, R5.1, R7.2, U1.3 (Vin+)
unnamed: R6.2, U2.2 (HI)
unnamed: R2.1, U2.7 (HO)
unnamed: C6.2, U2.6 (HS)
unnamed: R8.2, U2.3 (LI)
unnamed: R9.1, U2.5 (LO)
unnamed: R59.1, U3.1 (OUT)
unnamed: C18.1, C19.1, L2.2, R15.1, R17.2, U3.3 (Vin+)
unnamed: R16.2, U4.2 (HI)
unnamed: R12.1, U4.7 (HO)
unnamed: C16.2, U4.6 (HS)
unnamed: R18.2, U4.3 (LI)
unnamed: R19.1, U4.5 (LO)
unnamed: R60.1, U5.1 (OUT)
unnamed: C28.1, C29.1, L3.2, R28.1, R30.2, U5.3 (Vin+)
unnamed: R29.2, U7.2 (HI)
unnamed: R22.1, U7.7 (HO)
unnamed: C26.2, U7.6 (HS)
unnamed: R31.2, U7.3 (LI)
unnamed: R32.1, U7.5 (LO)
unnamed: R76.1, U8.1 (OUT)
unnamed: C42.1, C43.1, L4.2, R42.1, R45.2, U8.3 (Vin+)
unnamed: R43.2, U10.2 (HI)
unnamed: R35.1, U10.7 (HO)
unnamed: C37.2, U10.6 (HS)
unnamed: R47.2, U10.3 (LI)
unnamed: R50.1, U10.5 (LO)
unnamed: TP9.1 (1_1), U12.26 (PA15)
unnamed: TP13.1 (1_1), U12.32 (PB8)
unnamed: TP12.1 (1_1), U12.1 (PB9)
unnamed: TP10.1 (1_1), U12.20 (PC6)
unnamed: U12.2 (PC14), Y1.3 (OUT)
unnamed: TP11.1 (1_1), U12.3 (PC15)
unnamed: R67.1, Y1.1 (Tri-State)
PWM_1: R36.1, R40.1, U9.2 (1A), U11.2 (1B), U12.15 (PB0)
PWM_1_HIGH: R6.1, U9.1 (1Y)
PWM_1_LOW: R8.1, U11.3 (1Y)
PWM_2: R44.1, R48.1, U9.5 (2A), U11.5 (2B), U12.13 (PA6)
PWM_2_HIGH: R16.1, U9.4 (2Y)
PWM_2_LOW: R18.1, U11.6 (2Y)
PWM_3: R46.1, R49.1, U9.9 (3B), U11.9 (3A), U12.18 (PA8)
PWM_3_HIGH: R29.1, U9.10 (3Y)
PWM_3_LOW: R31.1, U11.8 (3Y)
PWM_4: R37.1, R41.1, U9.12 (4B), U11.12 (4A), U12.30 (PB6)
PWM_4_HIGH: R43.1, U9.13 (4Y)
PWM_4_LOW: R47.1, U11.11 (4Y)
RESET: C47.1, R63.1, SW1.1, U12.6 (NRST)
SWCLK: R62.1, U12.25 (PA14)
SWDIO: R61.1, U12.24 (PA13)
UART_RX: R65.1, U12.10 (PA3)
UART_TX: R66.1, U12.9 (PA2)
