silabs-MikeY/Peltier-Cell-Driver/(commit log)

2026-09-07 added project
    [ADC_Board-B_Cu.gbr, ADC_Board-B_Mask.gbr, ADC_Board-B_Paste.gbr, ADC_Board-B_Silkscreen.gbr, ADC_Board-Edge_Cuts.gbr, ADC_Board-F_Cu.gbr, ADC_Board-F_Mask.gbr, ADC_Board-F_Paste.gbr]
2026-09-09 changed I2C temp sensor to thermistor
    [ADC_Board.kicad_pcb, ADC_Board.kicad_sch, output.kicad_sch, outputs.kicad_sch, temperature_sensor.kicad_sch, temperature_sensors.kicad_sch]
2026-09-18 Placed designators
    [ADC_Board-B_Cu.gbr, ADC_Board-B_Mask.gbr, ADC_Board-B_Paste.gbr, ADC_Board-B_Silkscreen.gbr, ADC_Board-Edge_Cuts.gbr, ADC_Board-F_Cu.gbr, ADC_Board-F_Mask.gbr, ADC_Board-F_Paste.gbr]
2026-09-21 generated production files
    [ADC_Board.csv, ADC_Board.kicad_sch, Rev1_bom.csv, Rev1_designators.csv, Rev1_positions.csv, bom.csv, output.kicad_sch, positions.csv]
2026-09-22 Rev1 Updated BOM
    [ADC_Board.kicad_pcb]
2026-09-23 updated BOM with LCSC Part Numbers
2026-09-23 Fixed DNP parts on BOM
    [ADC_Board.kicad_sch, Rev1_bom.csv, Rev1_positions.csv, output.kicad_sch, pwm_driver.kicad_sch]
2026-09-23 forgot to save before last commit
    [ADC_Board.kicad_pcb]
2026-09-24 got rid of redundant copper
    [ADC_Board.step]
